rizangg/RZGX-Rover-Controller/media/photos/prototype-MN128.jpg

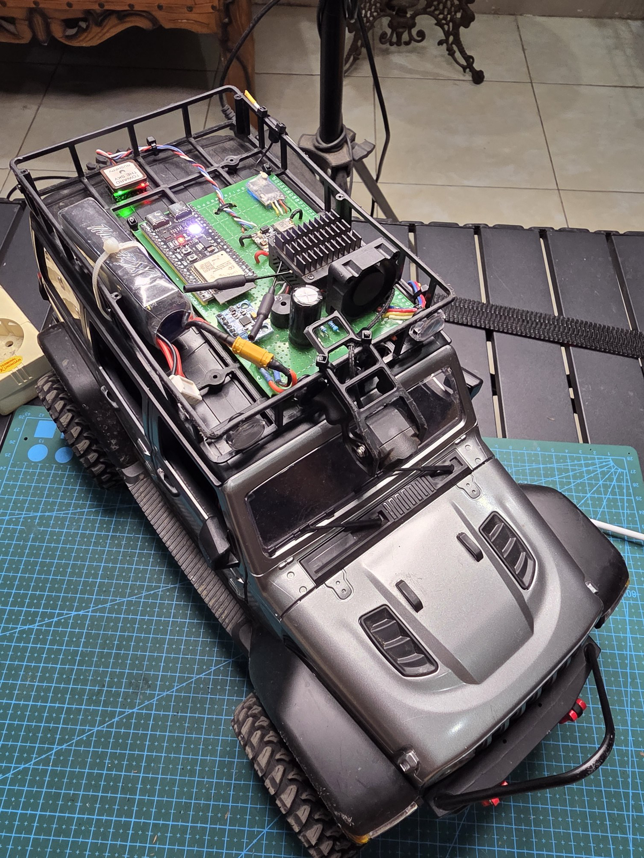
media/photos/prototype-MN128.jpg
