rizangg/RZGX-Rover-Controller/media/photos/prototype-perfboard-back.jpg

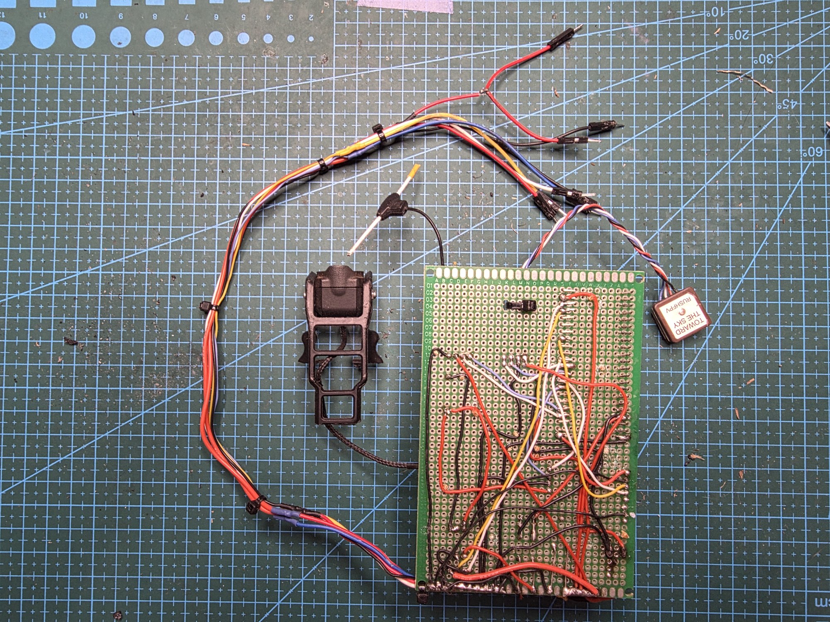
media/photos/prototype-perfboard-back.jpg
