rizangg/RZGX-Rover-Controller/media/photos/prototype-roof-rack-side.jpg

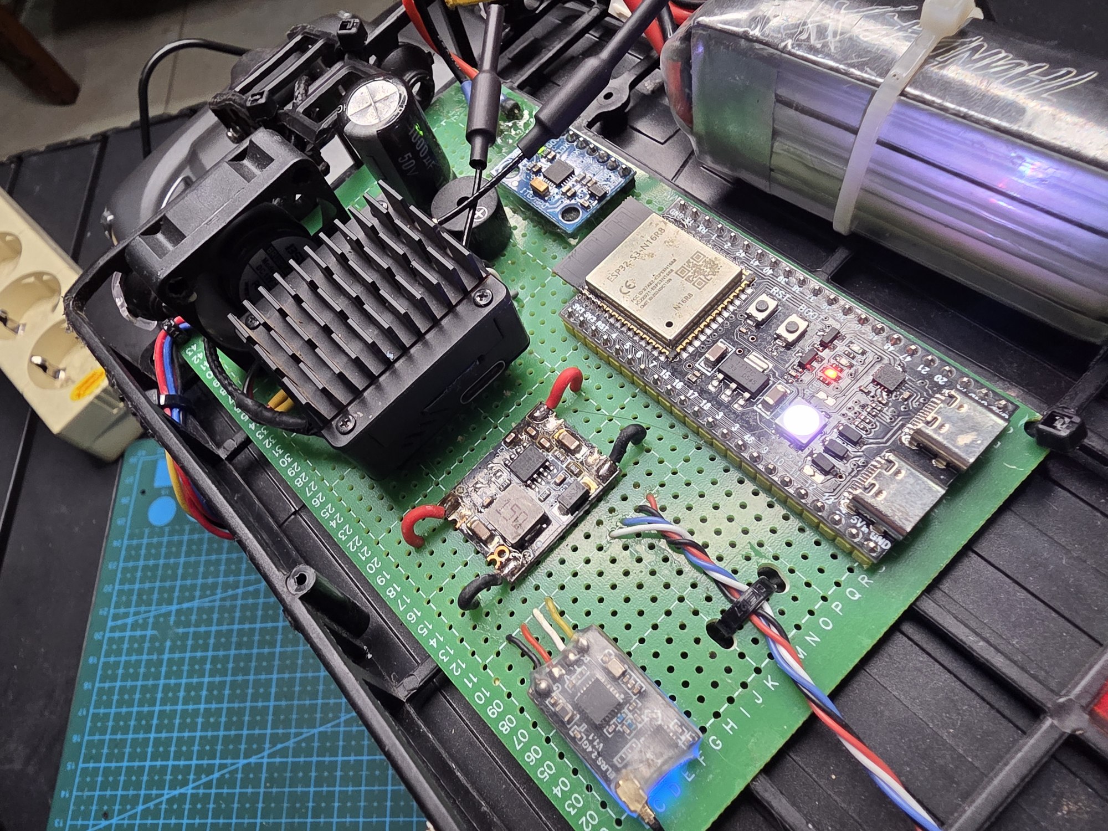
media/photos/prototype-roof-rack-side.jpg
