rizangg/RZGX-Rover-Controller/media/photos/prototype-top-view.jpg

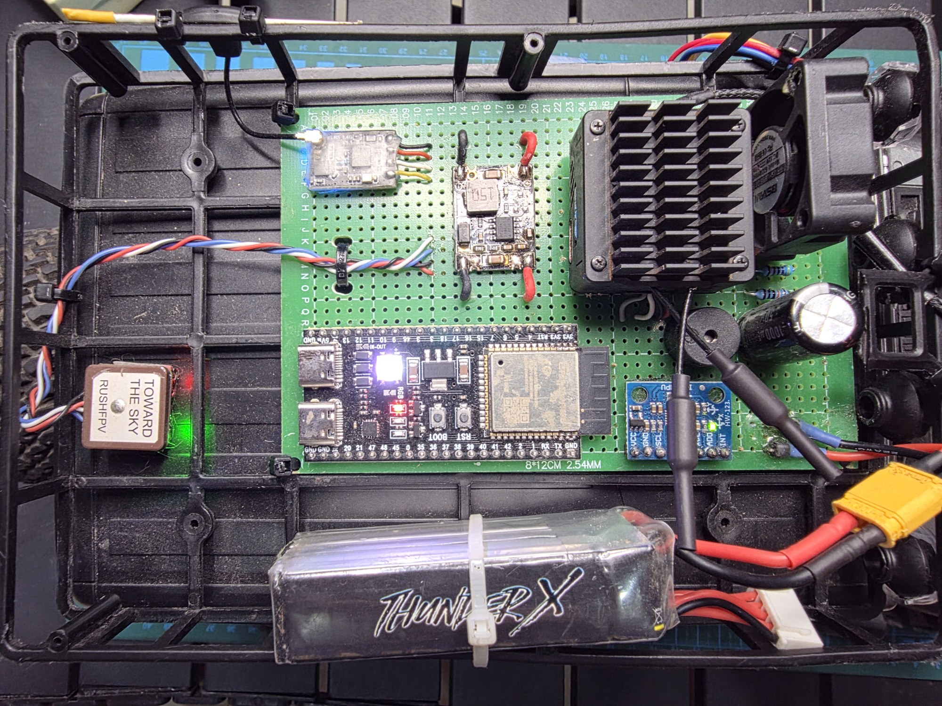
media/photos/prototype-top-view.jpg
