rizangg/RZGX-Rover-Controller/media/photos/prototype-wiring-bottom-risk.jpg

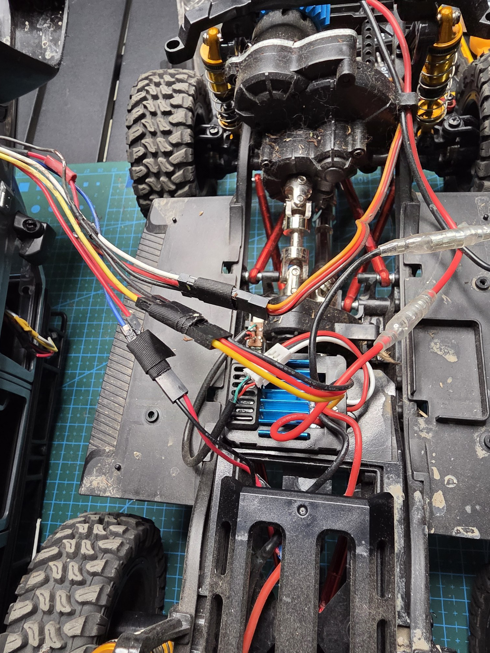
media/photos/prototype-wiring-bottom-risk.jpg
