rizangg/RZGX-Rover-Controller/(commit log)

2026-07-07 Enhance README with MN128 platform details
    Updated README.md to include detailed specifications for the MN128 RC platform, including battery and power management information.
2026-07-07 Update hardware wiring documentation for clarity
    Clarified battery voltage sensing and updated capacitor details.
2026-07-07 Enhance CONFIGURATOR_GUIDE with new gestures
    Added gestures for manual home point update and IMU calibration in the configurator guide.
2026-07-07 Document manual home point update and IMU calibration
    Added manual home point update gesture and IMU calibration methods.
